oyegunmen/JanFlight/docs/_sidebar.md

* **HOME**
  * [Introduction](README.md)

* **JANFLIGHT**
  * [Quick Start](content/quick-start.md)
  * [RP2040 / RP2350](content/rp2350-hardware-setup.md)
  * [ESP32 / ESP32-S3](content/esp32-hardware-setup.md)
  * [STM32](content/stm32-hardware-setup.md)
  * [Firmware](content/firmware.md)

* **EXAMPLES**
  * [Initial Setup](content/initial-setup.md)
  * [Quadcopter](content/quadcopter.md)
  * [5 Inch FPV](content/5-inch-fpv.md)

* **ADDITIONAL**
  * [Basics](content/basics.md)
  * [AHRS](content/ahrs.md)
  * [Licence](content/licence-contact.md)

* [**Github** ↗&#xFE0E;](https://github.com/oyegunmen/JanFlight)
