oyegunmen/JanFlight/docs/content/firmware.md

# Firmware

This firmware turns your **STM32**, **ESP32**, or **RP2350** into a high-performance flight controller by organizing the code into a few simple blocks.

Here is how the main system pieces interact to achieve stable flight:

```mermaid
flowchart TB
    Sensors[1. Read Sensors] --> Filter[2. Calculate Tilt]
    Radio[Radio Input] --> Pilot[3. Normalize Stick Commands]
    Filter --> PID[4. PID Correction Loop]
    Pilot --> PID
    PID --> Mixer[5. Motor Mixer & Safety]
    Mixer --> Output[6. ESC Motor Output]
```
## Core Principles

After the initial hardware setup, the main loop executes this entire 6-step pipeline on a strict, synchronized schedule as per looprate specified in code.

#### 1. SENSE (Reads Sensors)

`getIMUdata()`

The MCU pulls raw Gyroscope and Accelerometer data over I2C/SPI. It applies a low-pass filter to clean up the high-frequency electrical noise and mechanical vibrations caused by the spinning motors.

#### 2. ORIENT (Calculates Tilt)

`Mahony(...)`

The filtered motion data feeds into the mathematical Mahony AHRS Filter. This fuses the data to establish an accurate, real-time calculation of the drone's actual tilt in 3D space and optputs Roll, Pitch, Yaw in degrees.

#### 3. DESIRE (Listens to the Pilot & Safety)

`getCommands()` ➔ `failSafe()` ➔ `getDesState()`

Simultaneously, the firmware listens to your radio receiver. It smooths out signal noise, verifies failsafe conditions, and translates your physical stick positions into target angles (e.g., "The pilot wants to tilt 15 degrees forward").

#### 4. REACT (The PID Brain)

`controlANGLE()`

The Stabilization Engine compares Step 2 (where the drone is) with Step 3 (where pilot want it to be). The PID loop computes the control values for roll, pitch, and yaw to minimize orientation error.

#### 5. MIX (Motor Mixer)

`controlMixer()` ➔ `scaleCommands()`

The PID control values are mapped to your physical drone geometry. The mixer calculates which individual motors need to speed up or slow down for your specific frame layout (ex. QuadX).

#### 6. ACT (ESC Motor Output)

`commandMotors()` ➔ `loopRate()`

The MCU translates the final mixer values into electrical pulses and sends them to your Electronic Speed Controllers (ESCs) via PWM or OneShot125 protocols.

*Last Updated: 7th Aug 2026*
