oyegunmen/JanFlight/docs/content/esp32-hardware-setup.md

# ESP32 / ESP32-S3 Hardware Setup

This guide covers building a custom flight controller using an ESP32 breakout board.

This example uses a generic **ESP32 DevKitC**.

## Parts List

<table>
  <thead>
    <tr>
      <th>Part</th>
      <th>Specs</th>
      <th>Qty</th>
      <th>Price*<br>(₹)</th>
      <th>Link<br>(India)</th>
      <th>Price*<br>($)</th>
      <th>Link<br>(Global)</th>
    </tr>
  </thead>
  <tbody>
    <tr>
      <td rowspan="4">Dev Board<br><i>(Buy Any One)<i></td>
      <td>ESP32 38-Pin Type-C (Recommended)</td>
      <td>1</td>
      <td>599</td>
      <td><a href="https://www.flyrobo.in/esp32-38-pin-development-board-cp2102-type-c-wifi-and-bluetooth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" target="_blank">Buy</a></td>
      <td>3.92</td>
      <td><a href="https://s.click.aliexpress.com/e/_c2zoOAuH" target="_blank">Buy</a></td>
    </tr>
    <tr>
      <td>ESP32 38-Pin Micro USB</td>
      <td>1</td>
      <td>599</td>
      <td><a href="https://www.flyrobo.in/esp32-38-pin-development-board-dual-core-wifi-bluetooth-micro-usb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" target="_blank">Buy</a></td>
      <td>3.83</td>
      <td><a href="https://s.click.aliexpress.com/e/_c2zoOAuH" target="_blank">Buy</a></td>
    </tr>
    <tr>
      <td>ESP32 38-Pin Micro-USB</td>
      <td>1</td>
      <td>599</td>
      <td><a href="https://www.flyrobo.in/esp32-development-board-wifibluetooth-dual-core-38-pin-ch9102-micro-soldered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" target="_blank">Buy</a></td>
      <td>-</td>
      <td>-</td>
    </tr>
    <tr>
      <td>ESP32 30-Pin Micro-USB</td>
      <td>1</td>
      <td>499</td>
      <td><a href="https://www.flyrobo.in/esp32-development-board-wifibluetooth-dual-core-30-pin-ch9102-micro-soldered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" target="_blank">Buy</a></td>
      <td>-</td>
      <td>-</td>
    </tr>
    <tr>
      <td rowspan="2">IMU</td>
      <td>MPU6500</td>
      <td>1</td>
      <td>237</td>
      <td><a href="https://www.flyrobo.in/mpu6500-gy-6500-6dof-6-axis-accelerometer-gyro-sensor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" target="_blank">Buy</a></td>
      <td>1.09</td>
      <td><a href="https://s.click.aliexpress.com/e/_c42M3wvf" target="_blank">Buy</a></td>
    </tr>
    <tr>
      <td>-</td>
      <td>-</td>
      <td>-</td>
      <td>-</td>
      <td>-</td>
      <td>-</td>
    </tr>
    <tr>
      <td rowspan="12">Miscellaneous</td>
      <td>Soldering Iron</td>
      <td>1</td>
      <td>265</td>
      <td><a href="https://www.flyrobo.in/solder-iron-25w-yellow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" target="_blank">Buy</a></td>
      <td>5.66</td>
      <td><a href="https://s.click.aliexpress.com/e/_c4STxyiD" target="_blank">Buy</a></td>
    </tr>
    <tr>
      <td>Soldering Wire</td>
      <td>1</td>
      <td>245</td>
      <td><a href="https://www.flyrobo.in/solder-wire-40-gsm-for-most-electrical-repair-soldering-purpose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" target="_blank">Buy</a></td>
      <td>1.09</td>
      <td><a href="https://s.click.aliexpress.com/e/_c2QgiDwl" target="_blank">Buy</a></td>
    </tr>
    <tr>
      <td>Soldering Flux</td>
      <td>1</td>
      <td>21</td>
      <td><a href="https://www.flyrobo.in/noel-yellow-soldering-flux-paste-10gm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" target="_blank">Buy</a></td>
      <td>1.09</td>
      <td><a href="https://s.click.aliexpress.com/e/_c3cgdyod" target="_blank">Buy</a></td>
    </tr>
    <tr>
      <td>Double Side Perf Board</td>
      <td>1</td>
      <td>43</td>
      <td><a href="https://www.flyrobo.in/5-x-7-cm-double-side-universal-pcb-prototype-board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" target="_blank">Buy</a></td>
      <td>1.09</td>
      <td><a href="https://s.click.aliexpress.com/e/_c3gO30rj" target="_blank">Buy</a></td>
    </tr>
    <tr>
      <td>Black Silicon Wire (1 Meter, 24 AWG)</td>
      <td>1</td>
      <td>19</td>
      <td><a href="https://www.flyrobo.in/24awg-high-quality-black-silicon-wire-1meter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" target="_blank">Buy</a></td>
      <td>1.09</td>
      <td><a href="https://s.click.aliexpress.com/e/_c3EOY7Oz" target="_blank">Buy</a></td>
    </tr>
    <tr>
      <td>Wire Cutter</td>
      <td>1</td>
      <td>60</td>
      <td><a href="https://www.flyrobo.in/wire-stripper-and-cutter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" target="_blank">Buy</a></td>
      <td>1.09</td>
      <td><a href="https://s.click.aliexpress.com/e/_c4cew2tX" target="_blank">Buy</a></td>
    </tr>
    <tr>
      <td>Male Single Row Header Pins</td>
      <td>5</td>
      <td>40</td>
      <td><a href="https://www.flyrobo.in/40-pin-male-header-connector-strip-breakable-5pcs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" target="_blank">Buy</a></td>
      <td>1.09</td>
      <td><a href="https://s.click.aliexpress.com/e/_c4k7jl01" target="_blank">Buy</a></td>
    </tr>
    <tr>
      <td>Female Single Row Header Pins</td>
      <td>5</td>
      <td>85</td>
      <td><a href="https://www.flyrobo.in/2mm-pitch-female-burg-strip-40-pin-5-pcs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" target="_blank">Buy</a></td>
      <td>1.09</td>
      <td><a href="https://s.click.aliexpress.com/e/_c4MWwULb" target="_blank">Buy</a></td>
    </tr>
    <tr>
      <td>4 Pin Male JST Connector</td>
      <td>1</td>
      <td>2</td>
      <td><a href="https://quartzcomponents.com/collections/all/products/4-pin-jst-xh-male-connector-5-24mm-pitch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" target="_blank">Buy</a></td>
      <td>1.09</td>
      <td><a href="https://s.click.aliexpress.com/e/_c4B2jwtf" target="_blank">Buy</a></td>
    </tr>
    <tr>
      <td>4 Pin Female JST Connector</td>
      <td>1</td>
      <td>13</td>
      <td><a href="https://quartzcomponents.com/collections/all/products/4-pin-jst-sm-connector-with-wire-5-24mm-pitch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" target="_blank">Buy</a></td>
      <td>1.09</td>
      <td><a href="https://s.click.aliexpress.com/e/_c4B2jwtf" target="_blank">Buy</a></td>
    </tr>
    <tr>
      <td>Heat Shrink Tube</td>
      <td>1</td>
      <td>18</td>
      <td><a href="https://quartzcomponents.com/collections/all/products/heat-shrink-tube-6mm-diameter-black-1-meter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" target="_blank">Buy</a></td>
      <td>1.09</td>
      <td><a href="https://s.click.aliexpress.com/e/_c2vbHvI9" target="_blank">Buy</a></td>
    </tr>
    <tr>
      <td>3 Pin Female to Female Jumper Wire</td>
      <td>1</td>
      <td>24</td>
      <td><a href="https://www.flyrobo.in/70cm-3-pin-female-female-dupont-cable-for-3d-printer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" target="_blank">Buy</a></td>
      <td>0.49</td>
      <td><a href="https://s.click.aliexpress.com/e/_c4l7Dkzr" target="_blank">Buy</a></td>
    </tr>
  </tbody>
</table>

**prices as of 14th Sept 2026*

## Soldering

1. Get the required parts.

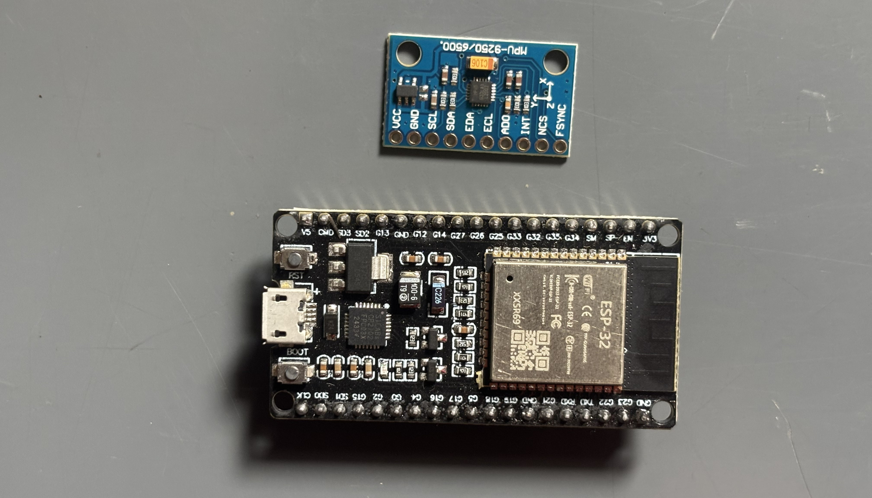
[picture p19: docs/static/parts_esp32.jpg]


2. Solder header pins to the board, matching the pin groups used in the wiring table below.



## Wiring

Connect components as outlined in the table below:

<table>
  <thead>
    <tr>
      <th>Component</th>
      <th>MCU Pin</th>
      <th>Part Pin</th>
      <th>Protocol</th>
    </tr>
  </thead>
  <tbody>
    <tr>
      <td rowspan="10"><strong>IMU</strong></td>
      <td>3.3 V</td>
      <td>VCC</td>
      <td rowspan="4">I2C</td>
    </tr>
    <tr>
      <td>GND</td>
      <td>GND</td>
    </tr>
    <tr>
      <td>GPIO22</td>
      <td>SCL</td>
    </tr>
    <tr>
      <td>GPIO21</td>
      <td>SDA</td>
    </tr>
    <tr>
      <td>3.3V</td>
      <td>VCC</td>
      <td rowspan="6">SPI</td>
    </tr>
    <tr>
      <td>GND</td>
      <td>GND</td>
    </tr>
    <tr>
      <td>GPIO18</td>
      <td>SCL</td>
    </tr>
    <tr>
      <td>GPIO23</td>
      <td>SDA</td>
    </tr>
    <tr>
      <td>GPIO19</td>
      <td>ADO</td>
    </tr>
    <tr>
      <td>GPIO5</td>
      <td>NCS</td>
    </tr>
    <tr>
      <td rowspan="4"><strong>Radio</strong></td>
      <td>GPIO4</td>
      <td>PPM/CH1</td>
      <td rowspan="4">PPM</td>
    </tr>
    <tr>
      <td>5 V</td>
      <td>Power</td>
    </tr>
    <tr>
      <td>GND</td>
      <td>GND</td>
    </tr>
    <tr>
      <td>-</td>
      <td>-</td>
    </tr>
    <tr>
      <td rowspan="4"><strong>ESC</strong></td>
      <td>GPIO25</td>
      <td>SIGNAL (ESC1)</td>
      <td rowspan="4">PWM/OneShot125</td>
    </tr>
    <tr>
      <td>GPIO26</td>
      <td>SIGNAL (ESC2)</td>
    </tr>
    <tr>
      <td>GPIO32</td>
      <td>SIGNAL (ESC3)</td>
    </tr>
    <tr>
      <td>GPIO33</td>
      <td>SIGNAL (ESC4)</td>
    </tr>
  </tbody>
</table>

**This ESP32 can support up to 8 PWM channels (as shown in their pinout diagrams), allowing you to connect up to 8 individual motors or servos.*



!> **Warning**: Cut or remove the positive (red) power wire from all ESC signal connectors. Connecting them directly to the board will cause voltage back-feeding, potentially damaging your ESCs or the MCU.

## Firmware Flash & Verification

Go to the [Initial Setup Guide](content/initial-setup.md), select your board ESP32, complete initial setup. Once done, follow the verification steps below to ensure everything works as intended.

1. Connect the ESP32 to your laptop via USB and flash the [Janflight firmware](https://github.com/oyegunmen/JanFlight/blob/main/src/ESP32/JanFlight_v1.0.0/JanFlight_v1.0.0.ino).

2. Onboard LED Indicators:
    * Three quick blinks indicating the start of the setup.
    * Two quick blinks indicating the start of the main loop.
    * Consistent 1-second interval blinking confirming the loop is running.

!> **Warning:** On the 38-pin ESP32 DevKitC, the onboard blue LED is physically hardwired to GPIO 1, which is the exact same pin used for the USB Serial Transmit (TX) line. You cannot use both simultaneously. Attempting to blink the onboard LED while sending data to the Serial Monitor may not print data.

3. Open the code in the Arduino IDE, scroll down to the main loop, and uncomment the following debug functions one by one, flashing the code each time to verify data in the Serial Monitor:
    * `printRadioData()`
    * `printRollPitchYaw()`
    * `printMotorCommands()`

If you are seeing data being printed in your serial monitor then your connections are fine.

Congratulations, your ESP32 based flight controller is ready for flying!

*Last Updated: 7th Aug 2026*
