oyegunmen/JanFlight/src/ESP32/JanFlight_v1.0.0/JanFlight_v1.0.0.ino

/*
Author: Dikshit Makwana
Project Start: 19/05/2026
Last Updated: 20/08/2026
Licence: GPL-3.0
Version: v1.0.0
Board: ESP32
*/

//========================================================================================================================//
//                                                    CREDIT & THANKS                                                     //
//========================================================================================================================//

/*
Inspired by:
https://github.com/nickrehm/dRehmFlight

Mahony ahrs filter adapted from:
https://ahrs.readthedocs.io/en/latest/filters/mahony.html
*/

//========================================================================================================================//
//                                              1. USER SPECIFIED DEFINES                                                 //
//========================================================================================================================//

// Choose receiver protocol (Uncomment only one)
#define USE_PPM_RX // Default
//#define USE_PWM_RX //Implementation Pending
//#define USE_IBUS_RX //Implementation Pending

// Choose IMU communication protocol
#define USE_MPU6500_SPI // Default; Runs at 10 MHZ data read frequency (250 times faster data read)
//#define USE_MPU6500_I2C // Runs at 400 kHZ data read frequency

// Choose ESC Communication Protocol
#define USE_PWM_PC // Signal Length from 1000-2000 us; Slower
//#define USE_ONESHOT_PC // Signal Length from 125-250 us; 8xFaster than PWM

// Choose full scale gyro range (deg/sec)
#define GYRO_250DPS // Default
//#define GYRO_500DPS
//#define GYRO_1000DPS
//#define GYRO_2000DPS

// Choose full scale accelerometer range (G's)
#define ACCEL_2G  // Default
//#define ACCEL_4G
//#define ACCEL_8G
//#define ACCEL_16G

// Channel Mapping (Default to FSi6 Radio; Mode 2)
#define CHAN_THROTTLE  channel_3_pc  // CH3 = Left stick up/down
#define CHAN_ROLL      channel_1_pc  // CH1 = Right stick left/right
#define CHAN_PITCH     channel_2_pc  // CH2 = Right stick up/down
#define CHAN_YAW       channel_4_pc  // CH4 = Left stick left/right
#define CHAN_KILL      channel_5_pc  // CH5 = SwC
#define CHAN_ARM       channel_6_pc  // CH6 = SwB

//========================================================================================================================//
//                                                  2. REQUIRED LIBRARIES                                                 //
//========================================================================================================================//

#include <Wire.h>  // I2c communication
#include <SPI.h>   // SPI communication
//#include <Servo.h> // Controlling Servos

//========================================================================================================================//
//                                         3. USER-SPECIFIED VARIABLE DECLARATION                                         //
//========================================================================================================================//

// Failsafe values (If the radio signal is lost, the code defaults to these values)
unsigned long channel_1_fs = 1500; // Roll
unsigned long channel_2_fs = 1500; // Pitch
unsigned long channel_3_fs = 1000; // Throttle
unsigned long channel_4_fs = 1500; // Yaw
unsigned long channel_5_fs = 1000; // SwC
unsigned long channel_6_fs = 1000; // SwB

// IMU Filter Parameters (Tuned for looprate frequency)

// Takes value between 0 and 1. A value of 0.20 means, 20% value from current loop & 90% from previous loop is applied to IMU Variables.
float B_accel = 0.2; // Accel Low-pass filter 
float B_gyro = 0.16;  // Gyro Low-pass filter

float twoKp = 2.0f * 0.4f; // Kp = 0.4; Mahony proportional gain; dictates how heavily the accelerometer is trusted to correct gyroscope drift over time
float twoKi = 2.0f * 0.0f; // Ki = 0.0; Mahony integral gain; handles long-term steady-state errors

// Controller Limits; Max tilt angles in degrees. (Basically When the radio stick is pushed to 100%, the drone will pitch/roll exactly this many degrees.)
float i_limit = 25.0;  // Maximum integrator error buildup
float maxRoll = 30.0;  // Angle mode max roll (degrees)
float maxPitch = 30.0; // Angle mode max pitch (degrees)
float maxYaw = 150.0;  // Yaw max rate (deg/sec)

// PID Gains (Kp is the immediate reaction to an error. Ki builds up over time. Kd dampens the reaction to stop oscillations.)
float Kp_roll_angle = 0.2, Ki_roll_angle = 0.3, Kd_roll_angle = 0.05;
float Kp_pitch_angle = 0.2, Ki_pitch_angle = 0.3, Kd_pitch_angle = 0.05;
float Kp_yaw = 0.3, Ki_yaw = 0.05, Kd_yaw = 0.00015;

// IMU Error Offsets (Run calculate_IMU_error() once to get these, then hardcode)
float AccErrorX = 0.00, AccErrorY = 0.00, AccErrorZ = 0.00;
float GyroErrorX = 0.00, GyroErrorY = 0.00, GyroErrorZ = 0.00;

// Data Logging frequency for troubleshooting (Higher the value, higher the stress on your MCU)
const int data_print_rate = 25;

//========================================================================================================================//
//                                                   4. PIN DECLARATION                                                   //
//========================================================================================================================//

// Based on ESP32 Nomenclature

// Radio Receiver Pins
const int PPM_Pin = 4; // PPM Input

// LED Pin
const int ledPin = 2; // The Blue LED (Pin 1 is tied to serial Transmit which can create problem while printing the data so use some other pin or disable it.)

// Pin for SPI
const int MPU_CS_PIN = 5; // SCL: 18, SDA: 23, ADO: 19 and NCS: 5
const int MPU_MOSI_PIN = 23;
const int MPU_MISO_PIN = 19;
const int MPU_SCL_PIN = 18;


// ESC Pins (More Servo and Motor pins will be defined in coming release)
const int m1Pin = 25;
const int m2Pin = 26;
const int m3Pin = 32;
const int m4Pin = 33;

// Servo Pins
//const int servo1Pin = PA3;
//const int servo2Pin = PB1;

//Servo servo1;
//Servo servo2;

//========================================================================================================================//
//                                               5. GLOBAL VARIABLE DECLARATION                                           //
//========================================================================================================================//

// Timing
float dt;
unsigned long current_time, prev_time;
unsigned long print_counter;

// Radio Data
unsigned long channel_1_pc, channel_2_pc, channel_3_pc, channel_4_pc, channel_5_pc, channel_6_pc;
volatile unsigned long channel_1_raw, channel_2_raw, channel_3_raw, channel_4_raw, channel_5_raw, channel_6_raw; // Background hardware routines write to these variables continously. The main loop safely copies and filters them into respective channel_x_pwm variable.
unsigned long channel_1_pc_prev, channel_2_pc_prev, channel_3_pc_prev, channel_4_pc_prev;
volatile int ppm_counter = 0;
volatile unsigned long time_ms = 0;

// LED State Tracking
unsigned long blink_counter = 0;
bool led_state = false;

// IMU & Mahony Data
float AccX, AccY, AccZ, AccX_prev, AccY_prev, AccZ_prev;
float GyroX, GyroY, GyroZ, GyroX_prev, GyroY_prev, GyroZ_prev;
float roll_IMU, pitch_IMU, yaw_IMU;
float q0 = 1.0f, q1 = 0.0f, q2 = 0.0f, q3 = 0.0f; // Quaternion for Mahony Filter
float integralFBx = 0.0f, integralFBy = 0.0f, integralFBz = 0.0f; // Integral error terms

// Desired State & PID
float thro_des, roll_des, pitch_des, yaw_des;
float error_roll, integral_roll, integral_roll_prev, derivative_roll, roll_PID = 0;
float error_pitch, integral_pitch, integral_pitch_prev, derivative_pitch, pitch_PID = 0;
float error_yaw, error_yaw_prev, integral_yaw, integral_yaw_prev, derivative_yaw, yaw_PID = 0;

// SPI Pins
SPIClass &mySPI = SPI;

// Command pulses

// ESC Communication Protocol Upper and Lower threshold values
#if defined USE_PWM_PC
  #define ESC_COMMAND_LT 1000.0
  #define ESC_COMMAND_UT 2000.0
  #define ESC_COMMAND_UNARMED 950.0
#elif defined USE_ONESHOT_PC
  #define ESC_COMMAND_LT 125.0
  #define ESC_COMMAND_UT 250.0
  #define ESC_COMMAND_UNARMED 120.0
#endif

//ESCs
float m1_command_scaled, m2_command_scaled, m3_command_scaled, m4_command_scaled;
int m1_command_pc, m2_command_pc, m3_command_pc, m4_command_pc;

//SERVOs
float s1_command_scaled, s2_command_scaled;
int s1_command_PWM, s2_command_PWM;

// Scale Factors for MPU6500
#if defined GYRO_250DPS
  #define GYRO_SCALE_FACTOR 131.0
#elif defined GYRO_500DPS
  #define GYRO_SCALE_FACTOR 65.5
#elif defined GYRO_1000DPS
  #define GYRO_SCALE_FACTOR 32.8
#elif defined GYRO_2000DPS
  #define GYRO_SCALE_FACTOR 16.4
#endif

#if defined ACCEL_2G
  #define ACCEL_SCALE_FACTOR 16384.0
#elif defined ACCEL_4G
  #define ACCEL_SCALE_FACTOR 8192.0
#elif defined ACCEL_8G
  #define ACCEL_SCALE_FACTOR 4096.0
#elif defined ACCEL_16G
  #define ACCEL_SCALE_FACTOR 2048.0
#endif

// Loop Cycle
#if defined USE_PWM_PC
  #define loopcycle 400
#elif defined USE_ONESHOT_PC
  #define loopcycle 1200
#endif

//========================================================================================================================//
//                                                       6. VOID SETUP                                                    //
//========================================================================================================================//

// pre-flight checklist
void setup() {
  // Establish serial connection to onboard USB
  Serial.begin(115200);
  //while (!Serial) {
  //  delay(10);
  //}
  delay(1000);

  //Indicate entering setup loop with 3 blinks
  pinMode(ledPin, OUTPUT);
  ledBlink(3,250,150);
  //Serial.println("--- Boot Begins ---");
  
  // Initialize all pins
  //Serial.print("Initializing Pins... ");
  pinMode(m1Pin, OUTPUT);
  pinMode(m2Pin, OUTPUT);
  pinMode(m3Pin, OUTPUT);
  pinMode(m4Pin, OUTPUT);
  //servo1.attach(servo1Pin, 900, 2100);
  //servo2.attach(servo2Pin, 900, 2100);
  //Serial.println("Done.");

  // Initialize communication with desired radio type
  //Serial.print("Configuring Radio... ");
  radioSetup();
  //Serial.println("Done.");

  // Failsafe setup: Default to safe values before main loop starts
  channel_1_pc = channel_1_fs;
  channel_2_pc = channel_2_fs;
  channel_3_pc = channel_3_fs;
  channel_4_pc = channel_4_fs;
  channel_5_pc = channel_5_fs;
  channel_6_pc = channel_6_fs;

  // Initialize IMU
  //Serial.print("Initializing IMU... ");
  IMUinit();
  //Serial.println("Done.");
  delay(50);

  // Get IMU error offset (Uncomment to calibrate, then write them into section 3 under IMU Error Offsets and re-comment)
  // Keep IMU on Flat Surface during Calibration
  // calculate_IMU_error(); 

  // Arm servo channels (write low)
  //Serial.print("Arming Servos... ");
  //servo1.write(90); 
  //servo2.write(90);
  //delay(5);
  //Serial.println("Done.");

  // Arm Motors (Write lowest valid pulse)
  //Serial.print("Arming ESCs... ");
  m1_command_pc = ESC_COMMAND_LT;
  m2_command_pc = ESC_COMMAND_LT;
  m3_command_pc = ESC_COMMAND_LT;
  m4_command_pc = ESC_COMMAND_LT;
  for (int i = 0; i < 50; i++) {
    commandMotors();
    delay(2);
  }
  //Serial.println("Done.");

  // Warms up IMU filter before entering main loop
  //Serial.print("Calibrating Attitude... ");
  calibrateAttitude();
  //Serial.println("Done.");

  //Indicate entering main loop with 2 quick blinks
  //Serial.println("--- Entering Main Loop ---");
  ledBlink(2,250,150);
  delay(800);
  current_time = micros();
}

//========================================================================================================================//
//                                                        7. VOID LOOP                                                    //
//========================================================================================================================//

// MCU runs these functions on repeat at looprate frequency
void loop() {
  // Track timing
  prev_time = current_time;
  current_time = micros();      
  dt = (current_time - prev_time) / 1000000.0;
  loopBlink(1300, 200);

  // Print Data at 50hz (Uncomment one by one for troubleshooting)
  // printRadioData(); // print Variables: channel_x_pc; Value Range: 1000-2000
  // printDesiredState(); // print Variables: thro_des. roll_des, pitch_des, yaw_des; Value Range: 0-1, -30 to 30, -30 to 30 and -120 to 120 
   printRollPitchYaw(); // print Variables : roll_IMU, pitch_IMU, yaw_IMU; Value Range: gives absolute angle relative to gravity vector
  // printScaledCommands(); // print Variables : mx_command_scaled; Value Range: Combination of throttle, roll, pitch and yaw PID value
  // printMotorCommands(); // print Variables : mx_command_pc; Value Range: 1000-2000 or 125-250
  // printServoCommands(); // print Variables : sx_command_scaled; Value Range: Combination of throttle, roll, pitch and yaw PID value
  // printLoopRate(); // print Variables : channel_x_pc
  // printPIDoutput(); // print Variables : roll_PID, pitch_PID, yaw_PID; Value Range: Individual PID value of roll, pitch and yaw axis

  // Pulls raw gyro/accel data and applies low-pass filter
  getIMUdata();

  // Uses IMU data to estimate absolute vehicle attitude
  Mahony(GyroX, -GyroY, -GyroZ, -AccX, AccY, AccZ, dt);

  // Convert raw radio commands to normalized bounds based on user limits
  getDesState();

  // PID control generating stabilized axis variables
  controlANGLE();

  // Mixes PID controller outputs to scaled actuator commands
  controlMixer();

  // Scale motor/actuator commands to required ranges
  scaleCommands();

  // Set motor commands to minimum if kill switch is engaged
  throttleCut();

  // Send exact pulse widths to ESCs and Servos
  commandMotors();
  //servo1.write(s1_command_PWM);
  //servo2.write(s2_command_PWM);

  // Get current radio commands to be used in next loop iteration
  getCommands();

  // Check validity of radio commands and overwrite with failsafe if bad
  failSafe();

  // Idle until loop boundary is reached
  loopRate(loopcycle); 
}

//========================================================================================================================//
//                                                       8. FUNCTIONS                                                     //
//========================================================================================================================//

// Helper function to write to MPU6500 registers over SPI
#if defined USE_MPU6500_SPI
void writeRegisterSPI(uint8_t reg, uint8_t data) {
  mySPI.beginTransaction(SPISettings(1000000, MSBFIRST, SPI_MODE3));
  digitalWrite(MPU_CS_PIN, LOW);
  mySPI.transfer(reg);
  mySPI.transfer(data);
  digitalWrite(MPU_CS_PIN, HIGH);
  mySPI.endTransaction();
}
#endif

// communicating with the MPU6500 using I2C protocol.
void IMUinit() {
  #if defined USE_MPU6500_I2C
    Wire.begin(21, 22); // SDA, SCL
    Wire.setClock(400000); // 400kHz I2C speed
    
    // Wake IMU
    Wire.beginTransmission(0x68);
    Wire.write(0x6B);
    Wire.write(0x00);
    Wire.endTransmission();
    
    // Set Gyro Config
    Wire.beginTransmission(0x68);
    Wire.write(0x1B);
    #if defined GYRO_250DPS
      Wire.write(0x00);
    #elif defined GYRO_500DPS
      Wire.write(0x08);
    #elif defined GYRO_1000DPS
      Wire.write(0x10);
    #elif defined GYRO_2000DPS
      Wire.write(0x18);
    #endif
    Wire.endTransmission();
    
    // Set Accel Config (2G)
    Wire.beginTransmission(0x68);
    Wire.write(0x1C);
    #if defined ACCEL_2G
      Wire.write(0x00);
    #elif defined ACCEL_4G
      Wire.write(0x08);
    #elif defined ACCEL_8G
      Wire.write(0x10);
    #elif defined ACCEL_16G
      Wire.write(0x18);
    #endif
    Wire.endTransmission();

  #elif defined USE_MPU6500_SPI
    pinMode(MPU_CS_PIN, OUTPUT);
    digitalWrite(MPU_CS_PIN, HIGH);
    
    mySPI.begin(MPU_SCL_PIN, MPU_MISO_PIN, MPU_MOSI_PIN, MPU_CS_PIN);
    
    // Wake IMU
    writeRegisterSPI(0x6B, 0x00);
    delay(10);
    
    // Disable I2C interface (Locks MPU into SPI mode)
    writeRegisterSPI(0x6A, 0x10);
    delay(1);
    
    // Set Gyro Config
    #if defined GYRO_250DPS
      writeRegisterSPI(0x1B, 0x00);
    #elif defined GYRO_500DPS
      writeRegisterSPI(0x1B, 0x08);
    #elif defined GYRO_1000DPS
      writeRegisterSPI(0x1B, 0x10);
    #elif defined GYRO_2000DPS
      writeRegisterSPI(0x1B, 0x18);
    #endif
    
    // Set Accel Config (2G)
    #if defined ACCEL_2G
      writeRegisterSPI(0x1C, 0x00);
    #elif defined ACCEL_4G
      writeRegisterSPI(0x1C, 0x08);
    #elif defined ACCEL_8G
      writeRegisterSPI(0x1C, 0x10);
    #elif defined ACCEL_16G
      writeRegisterSPI(0x1C, 0x18);
    #endif
  #endif
}

// Pulls data from IMU
void getIMUdata() {
  int16_t AcX, AcY, AcZ, Temp, GyX, GyY, GyZ;

  #if defined USE_MPU6500_I2C
    Wire.beginTransmission(0x68);
    Wire.write(0x3B);
    Wire.endTransmission(false);
    Wire.requestFrom(0x68, 14, true);

    AcX = Wire.read() << 8 | Wire.read();
    AcY = Wire.read() << 8 | Wire.read();
    AcZ = Wire.read() << 8 | Wire.read();
    Temp = Wire.read() << 8 | Wire.read();
    GyX = Wire.read() << 8 | Wire.read();
    GyY = Wire.read() << 8 | Wire.read();
    GyZ = Wire.read() << 8 | Wire.read();

  #elif defined USE_MPU6500_SPI
    mySPI.beginTransaction(SPISettings(10000000, MSBFIRST, SPI_MODE3));
    digitalWrite(MPU_CS_PIN, LOW);
    
    mySPI.transfer(0x3B | 0x80);
    
    AcX = mySPI.transfer(0x00) << 8 | mySPI.transfer(0x00);
    AcY = mySPI.transfer(0x00) << 8 | mySPI.transfer(0x00);
    AcZ = mySPI.transfer(0x00) << 8 | mySPI.transfer(0x00);
    Temp = mySPI.transfer(0x00) << 8 | mySPI.transfer(0x00);
    GyX = mySPI.transfer(0x00) << 8 | mySPI.transfer(0x00);
    GyY = mySPI.transfer(0x00) << 8 | mySPI.transfer(0x00);
    GyZ = mySPI.transfer(0x00) << 8 | mySPI.transfer(0x00);

    digitalWrite(MPU_CS_PIN, HIGH);
    mySPI.endTransaction();
  #endif

  // Scale and apply calculated calibration errors
  AccX = (AcX / ACCEL_SCALE_FACTOR) - AccErrorX;
  AccY = (AcY / ACCEL_SCALE_FACTOR) - AccErrorY;
  AccZ = (AcZ / ACCEL_SCALE_FACTOR) - AccErrorZ;
  
  GyroX = (GyX / GYRO_SCALE_FACTOR) - GyroErrorX;
  GyroY = (GyY / GYRO_SCALE_FACTOR) - GyroErrorY;
  GyroZ = (GyZ / GYRO_SCALE_FACTOR) - GyroErrorZ;

  // Apply Low-pass filter to remove vibration noise
  AccX = (1.0 - B_accel)*AccX_prev + B_accel*AccX;
  AccY = (1.0 - B_accel)*AccY_prev + B_accel*AccY;
  AccZ = (1.0 - B_accel)*AccZ_prev + B_accel*AccZ;
  AccX_prev = AccX; AccY_prev = AccY; AccZ_prev = AccZ;

  GyroX = (1.0 - B_gyro)*GyroX_prev + B_gyro*GyroX;
  GyroY = (1.0 - B_gyro)*GyroY_prev + B_gyro*GyroY;
  GyroZ = (1.0 - B_gyro)*GyroZ_prev + B_gyro*GyroZ;
  GyroX_prev = GyroX; GyroY_prev = GyroY; GyroZ_prev = GyroZ;
}

// Mahony filter for 6DOF IMU (Gyro + Accel) Computes orientation based on gravity vector.
void Mahony(float gx, float gy, float gz, float ax, float ay, float az, float invSampleFreq) {
  float recipNorm;
  float half_vx, half_vy, half_vz;
  float half_ex, half_ey, half_ez;
  float qa, qb, qc;

  // Convert gyro to radians
  gx *= 0.0174533f; gy *= 0.0174533f; gz *= 0.0174533f;

  if(!((ax == 0.0f) && (ay == 0.0f) && (az == 0.0f))) {
    // Normalise accelerometer measurement
    recipNorm = 1.0f / sqrt(ax * ax + ay * ay + az * az);
    ax *= recipNorm; ay *= recipNorm; az *= recipNorm;

    // Estimated direction of gravity (You get following value by multiplying rotation matrix of quaternion with column gravity vector)
    half_vx = q1 * q3 - q0 * q2;
    half_vy = q0 * q1 + q2 * q3;
    half_vz = q0 * q0 - 0.5f + q3 * q3;

    // Error is cross product between estimated and measured direction of gravity
    half_ex = (ay * half_vz - az * half_vy);
    half_ey = (az * half_vx - ax * half_vz);
    half_ez = (ax * half_vy - ay * half_vx);

    if(twoKi > 0.0f) {
      integralFBx += twoKi * half_ex * invSampleFreq;
      integralFBy += twoKi * half_ey * invSampleFreq;
      integralFBz += twoKi * half_ez * invSampleFreq;
      gx += integralFBx; gy += integralFBy; gz += integralFBz;
    }

    // Apply proportional feedback
    gx += twoKp * half_ex;
    gy += twoKp * half_ey;
    gz += twoKp * half_ez;
  }

  // Integrate rate of change of quaternion
  gx *= (0.5f * invSampleFreq);
  gy *= (0.5f * invSampleFreq);
  gz *= (0.5f * invSampleFreq);
  qa = q0; qb = q1; qc = q2;
  q0 += (-qb * gx - qc * gy - q3 * gz);
  q1 += (qa * gx + qc * gz - q3 * gy);
  q2 += (qa * gy - qb * gz + q3 * gx);
  q3 += (qa * gz + qb * gy - qc * gx);

  // Normalise quaternion
  recipNorm = 1.0f / sqrt(q0 * q0 + q1 * q1 + q2 * q2 + q3 * q3);
  q0 *= recipNorm; q1 *= recipNorm; q2 *= recipNorm; q3 *= recipNorm;

  // Compute roll, pitch, yaw from quaternions in degrees
  roll_IMU = atan2(q0*q1 + q2*q3, 0.5f - q1*q1 - q2*q2) * 57.29577951;
  pitch_IMU = -asin(constrain(-2.0f * (q1*q3 - q0*q2), -0.999999, 0.999999)) * 57.29577951;
  yaw_IMU = -atan2(q1*q2 + q0*q3, 0.5f - q2*q2 - q3*q3) * 57.29577951;
}

// Convert RC microsecond inputs (1000-2000) to normalized limits
void getDesState() {
  thro_des = constrain((CHAN_THROTTLE - 1000.0)/1000.0, 0.0, 1.0); 
  roll_des = constrain((CHAN_ROLL - 1500.0)/500.0, -1.0, 1.0) * maxRoll;
  pitch_des = constrain((CHAN_PITCH - 1500.0)/500.0, -1.0, 1.0) * maxPitch;
  yaw_des = constrain((CHAN_YAW - 1500.0)/500.0, -1.0, 1.0) * maxYaw;
}

// Standard PID processing
void controlANGLE() {
  // Roll
  error_roll = roll_des - roll_IMU;
  integral_roll = constrain(integral_roll_prev + error_roll*dt, -i_limit, i_limit);
  if (CHAN_THROTTLE < 1060) integral_roll = 0;
  derivative_roll = GyroX;
  roll_PID = 0.01*(Kp_roll_angle*error_roll + Ki_roll_angle*integral_roll - Kd_roll_angle*derivative_roll); 

  // Pitch
  error_pitch = pitch_des - pitch_IMU;
  integral_pitch = constrain(integral_pitch_prev + error_pitch*dt, -i_limit, i_limit);
  if (CHAN_THROTTLE < 1060) integral_pitch = 0;
  derivative_pitch = GyroY;
  pitch_PID = 0.01*(Kp_pitch_angle*error_pitch + Ki_pitch_angle*integral_pitch - Kd_pitch_angle*derivative_pitch);

  // Yaw (Stabilizes on rate, not absolute angle)
  error_yaw = yaw_des - GyroZ;
  integral_yaw = constrain(integral_yaw_prev + error_yaw*dt, -i_limit, i_limit);
  if (CHAN_THROTTLE < 1060) integral_yaw = 0;
  derivative_yaw = (error_yaw - error_yaw_prev)/dt;
  yaw_PID = 0.01*(Kp_yaw*error_yaw + Ki_yaw*integral_yaw + Kd_yaw*derivative_yaw); 

  // Updates variables for next loop
  integral_roll_prev = integral_roll;
  integral_pitch_prev = integral_pitch;
  error_yaw_prev = error_yaw;
  integral_yaw_prev = integral_yaw;
}

// Map PID outputs to physical actuators (QuadX setup example)
void controlMixer() {
  m1_command_scaled = thro_des - pitch_PID + roll_PID + yaw_PID; // Front Left
  m2_command_scaled = thro_des - pitch_PID - roll_PID - yaw_PID; // Front Right
  m3_command_scaled = thro_des + pitch_PID - roll_PID + yaw_PID; // Back Right
  m4_command_scaled = thro_des + pitch_PID + roll_PID - yaw_PID; // Back Left

  s1_command_scaled = 0.5; // Centered  (Not yet implemented properly)
  s2_command_scaled = 0.5; // Centered
}

// Scale motor mixer outputs into OneShot125 microsecond ranges
void scaleCommands() {
  m1_command_pc = constrain(m1_command_scaled*ESC_COMMAND_LT + ESC_COMMAND_LT, ESC_COMMAND_LT, ESC_COMMAND_UT);
  m2_command_pc = constrain(m2_command_scaled*ESC_COMMAND_LT + ESC_COMMAND_LT, ESC_COMMAND_LT, ESC_COMMAND_UT);
  m3_command_pc = constrain(m3_command_scaled*ESC_COMMAND_LT + ESC_COMMAND_LT, ESC_COMMAND_LT, ESC_COMMAND_UT);
  m4_command_pc = constrain(m4_command_scaled*ESC_COMMAND_LT + ESC_COMMAND_LT, ESC_COMMAND_LT, ESC_COMMAND_UT);

  // Scale servos to 0-180 degrees
  s1_command_PWM = constrain(s1_command_scaled*180, 0, 180);
  s2_command_PWM = constrain(s2_command_scaled*180, 0, 180);
}

// Arming, disarming and Kill Switch
void throttleCut() {
  if (CHAN_KILL < 1250) {
    m1_command_pc = ESC_COMMAND_UNARMED;
    m2_command_pc = ESC_COMMAND_UNARMED;
    m3_command_pc = ESC_COMMAND_UNARMED;
    m4_command_pc = ESC_COMMAND_UNARMED;
  } else if (CHAN_KILL > 1750) {
    m1_command_pc = ESC_COMMAND_UNARMED;
    m2_command_pc = ESC_COMMAND_UNARMED;
    m3_command_pc = ESC_COMMAND_UNARMED;
    m4_command_pc = ESC_COMMAND_UNARMED;
  } else {
    if (CHAN_THROTTLE < 1050) {
      m1_command_pc = ESC_COMMAND_LT;
      m2_command_pc = ESC_COMMAND_LT;
      m3_command_pc = ESC_COMMAND_LT;
      m4_command_pc = ESC_COMMAND_LT;
    }
  }
}

// Pulls designated motor pins HIGH, waits for microsecond limits, and pulls LOW.
void commandMotors() {
  int wentLow = 0;
  int pulseStart, timer;
  int flagM1 = 0, flagM2 = 0, flagM3 = 0, flagM4 = 0;
  
  digitalWrite(m1Pin, HIGH);
  digitalWrite(m2Pin, HIGH);
  digitalWrite(m3Pin, HIGH);
  digitalWrite(m4Pin, HIGH);
  pulseStart = micros();

  while (wentLow < 4) { 
    timer = micros();
    if ((m1_command_pc <= timer - pulseStart) && (flagM1==0)) { digitalWrite(m1Pin, LOW); wentLow++; flagM1 = 1; }
    if ((m2_command_pc <= timer - pulseStart) && (flagM2==0)) { digitalWrite(m2Pin, LOW); wentLow++; flagM2 = 1; }
    if ((m3_command_pc <= timer - pulseStart) && (flagM3==0)) { digitalWrite(m3Pin, LOW); wentLow++; flagM3 = 1; }
    if ((m4_command_pc <= timer - pulseStart) && (flagM4==0)) { digitalWrite(m4Pin, LOW); wentLow++; flagM4 = 1; }
  }
}

// Low-pass filter for the radio commands to iron out jitter
void getCommands() {
  float b = 0.7; 
  channel_1_pc = (1.0 - b)*channel_1_pc_prev + b*channel_1_raw;
  channel_2_pc = (1.0 - b)*channel_2_pc_prev + b*channel_2_raw;
  channel_3_pc = (1.0 - b)*channel_3_pc_prev + b*channel_3_raw;
  channel_4_pc = (1.0 - b)*channel_4_pc_prev + b*channel_4_raw;
  channel_5_pc = channel_5_raw; // Switches Don't require filter ;)
  channel_6_pc = channel_6_raw;

  channel_1_pc_prev = channel_1_pc;
  channel_2_pc_prev = channel_2_pc;
  channel_3_pc_prev = channel_3_pc;
  channel_4_pc_prev = channel_4_pc;
}

// Checks if radio link sends absolute garbage and overwrites with defaults
void failSafe() {
  if (CHAN_THROTTLE < 800 || CHAN_THROTTLE > 2200 || 
      CHAN_ROLL < 800 || CHAN_ROLL > 2200) {
    channel_1_pc = channel_1_fs;
    channel_2_pc = channel_2_fs;
    channel_3_pc = channel_3_fs;
    channel_4_pc = channel_4_fs;
    channel_5_pc = channel_5_fs;
    channel_6_pc = channel_6_fs;
  }
}

// Idle CPU until time allows for exact loop execution speed
void loopRate(int freq) {
  float invFreq = 1.0 / freq * 1000000.0;
  unsigned long checker = micros();
  while (invFreq > (checker - current_time)) {
    checker = micros();
  }
}

// Initialize communication with Radio
void radioSetup() {
  #if defined USE_PPM_RX
    pinMode(PPM_Pin, INPUT_PULLUP);
    attachInterrupt(digitalPinToInterrupt(PPM_Pin), getPPM, CHANGE);
  #endif
}

//----------------------------------------------------------
// PPM Interrupt Service Routine
//----------------------------------------------------------
// This runs completely outside the main loop, so we don't miss any radio signal.
// It interrupt triggers, measures the time since the last trigger, and dumps that time into the correct radio channel variable.
void getPPM() {
  unsigned long dt_ppm;
  int trig = digitalRead(PPM_Pin);

  if (trig == 1) {
    dt_ppm = micros() - time_ms;
    time_ms = micros();

    if (dt_ppm > 5000) { 
      ppm_counter = 0; 
    }

    if (ppm_counter == 1) channel_1_raw = dt_ppm;
    if (ppm_counter == 2) channel_2_raw = dt_ppm;
    if (ppm_counter == 3) channel_3_raw = dt_ppm;
    if (ppm_counter == 4) channel_4_raw = dt_ppm;
    if (ppm_counter == 5) channel_5_raw = dt_ppm;
    if (ppm_counter == 6) channel_6_raw = dt_ppm;

    ppm_counter++;
  }
}

//-----------------------------------------------------
// Functions used for calibration and error calculation
//-----------------------------------------------------
// Let the Mahony filter get some data for a few seconds so orientation is stable before arming.
void calibrateAttitude() {
  for (int i = 0; i < 4000; i++) {
    prev_time = current_time;
    current_time = micros();      
    dt = (current_time - prev_time)/1000000.0; 
    getIMUdata();
    Mahony(GyroX, -GyroY, -GyroZ, -AccX, AccY, AccZ, dt);
  }
}

// Run this on a flat surface to get your specific IMU biases; averages 8,000 readings to find that exact baseline offset so it can be subtracted during flight.
void calculate_IMU_error() {
  float sumAccX = 0, sumAccY = 0, sumAccZ = 0;
  float sumGyroX = 0, sumGyroY = 0, sumGyroZ = 0;
  int c = 0;
  delay(5000);
  
  while (c < 8000) {
    getIMUdata();
    sumAccX += AccX; sumAccY += AccY; sumAccZ += AccZ;
    sumGyroX += GyroX; sumGyroY += GyroY; sumGyroZ += GyroZ;
    c++;
    delay(1);
  }
  
  Serial.print("AccErrorX: "); Serial.println(sumAccX / c);
  Serial.print("AccErrorY: "); Serial.println(sumAccY / c);
  Serial.print("AccErrorZ: "); Serial.println((sumAccZ / c) - 1.0); // Gravity offset
  Serial.print("GyroErrorX: "); Serial.println(sumGyroX / c);
  Serial.print("GyroErrorY: "); Serial.println(sumGyroY / c);
  Serial.print("GyroErrorZ: "); Serial.println(sumGyroZ / c);
  
  while(1); // Halt execution so you can copy the values
}

//----------------------------------------------------------------
// Function to visually confirm particular Actions by LED Blinking
//----------------------------------------------------------------
void ledBlink(int numBlinks,int upTime, int downTime) {
  for (int j = 1; j<= numBlinks; j++) {
    digitalWrite(ledPin, HIGH);
    delay(upTime);
    digitalWrite(ledPin, LOW);
    delay(downTime);
  }
}

// LED Blink function for Main Loop
void loopBlink(int upTime, int downTime) {
  if (led_state == false && (current_time - blink_counter > downTime * 1000UL)) {
    blink_counter = current_time;
    led_state = true;
    digitalWrite(ledPin, HIGH);
  } 
  else if (led_state == true && (current_time - blink_counter > upTime * 1000UL)) {
    blink_counter = current_time;
    led_state = false;
    digitalWrite(ledPin, LOW);
  }
}

//----------------------------------------------------------------------------------
// Functions for Troubleshooting & Data Printing. Will add more in upcoming Versions
//----------------------------------------------------------------------------------
void printRadioData() {
  if (current_time - print_counter > 1000000/data_print_rate) {
    print_counter = micros();
    Serial.print("CH1:"); Serial.print(channel_3_pc); Serial.print(",");
    Serial.print("CH2:"); Serial.print(channel_1_pc); Serial.print(",");
    Serial.print("CH3:"); Serial.print(channel_2_pc); Serial.print(",");
    Serial.print("CH4:"); Serial.print(channel_4_pc); Serial.print(",");
    Serial.print("CH5:"); Serial.print(channel_5_pc); Serial.print(",");
    Serial.print("CH6:"); Serial.println(channel_6_pc);
  }
}

void printDesiredState() {
  if (current_time - print_counter > 1000000/data_print_rate) {
    print_counter = micros();
    Serial.print("Throttle:"); Serial.print(thro_des); Serial.print(",");
    Serial.print("Roll:"); Serial.print(roll_des); Serial.print(",");
    Serial.print("Pitch:"); Serial.print(pitch_des); Serial.print(",");
    Serial.print("Yaw:"); Serial.println(yaw_des);
  }
}

void printRollPitchYaw() {
  if (current_time - print_counter > 1000000/data_print_rate) {
    print_counter = micros();
    Serial.print("Roll:"); Serial.print(roll_IMU); Serial.print(",");
    Serial.print("Pitch:"); Serial.print(pitch_IMU); Serial.print(",");
    Serial.print("Yaw:"); Serial.println(yaw_IMU);
  }
}

void printScaledCommands() {
  if (current_time - print_counter > 1000000/data_print_rate) {
    print_counter = micros();
    Serial.print("SC_M1:"); Serial.print(m1_command_scaled); Serial.print(",");
    Serial.print("SC_M2:"); Serial.print(m2_command_scaled); Serial.print(",");
    Serial.print("SC_M3:"); Serial.print(m3_command_scaled); Serial.print(",");
    Serial.print("SC_M4:"); Serial.println(m4_command_scaled);
  }
}

void printMotorCommands() {
  if (current_time - print_counter > 1000000/data_print_rate) {
    print_counter = micros();
    Serial.print("M1:"); Serial.print(m1_command_pc); Serial.print(",");
    Serial.print("M2:"); Serial.print(m2_command_pc); Serial.print(",");
    Serial.print("M3:"); Serial.print(m3_command_pc); Serial.print(",");
    Serial.print("M4:"); Serial.println(m4_command_pc);
  }
}

void printServoCommands() {
  if (current_time - print_counter > 1000000/data_print_rate) {
    print_counter = micros();
    Serial.print("S1: "); Serial.print(s1_command_PWM); Serial.print(",");
    Serial.print("S2: "); Serial.println(s2_command_PWM);
  }
}

void printPIDoutput() {
  if (current_time - print_counter > 1000000/data_print_rate) {
    print_counter = micros();
    Serial.print("roll_PID:"); Serial.print(roll_PID); Serial.print(",");
    Serial.print("pitch_PID:"); Serial.print(pitch_PID); Serial.print(",");    
    Serial.print("yaw_PID:"); Serial.println(yaw_PID);    
  }
}

void printLoopRate() {
  if (current_time - print_counter > 1000000/data_print_rate) {
    print_counter = micros();
    Serial.print("dt:"); Serial.println(dt*1000000.0);
  }
}
