oyegunmen/JanFlight/(commit log)

2026-06-06 Refactor code blocks after initial testing
    [STM32F405RGT6.csv]
2026-07-13 Added Support for ESP32
