oyegunmen/JanFlight/(notices)

Notices in the files:
README.md:
License: GPLv3
